coredump/27v66_i2c_intercept_promicro/electronics/ProMicro3.3V.step

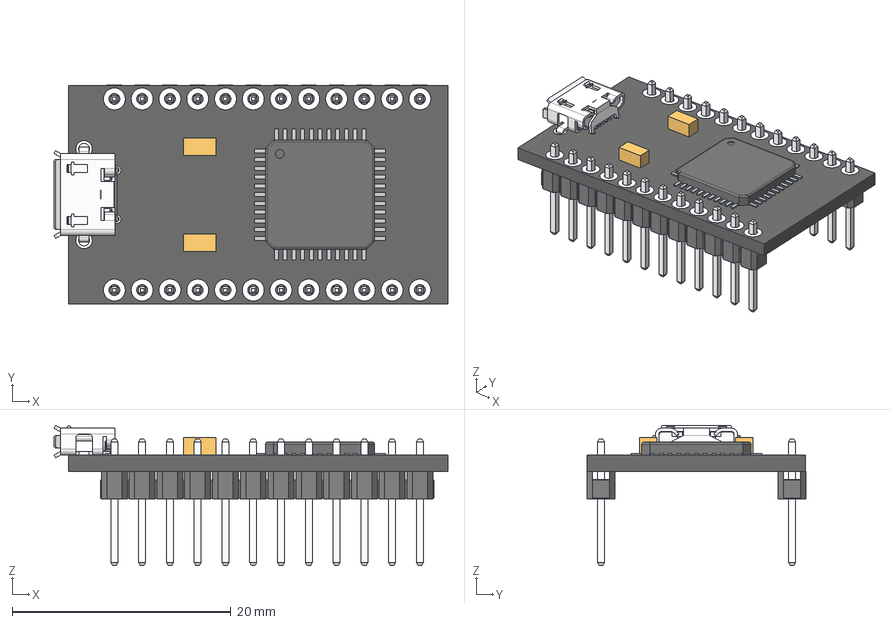
[picture p1: CAD file, 2021-08-10]
electronics/ProMicro3.3V.step
36.0 x 20.0 x 12.8 mm
Composants
pin x 24
PCB
USB
