coredump/27v66_i2c_intercept_promicro/electronics/electronics.pdf

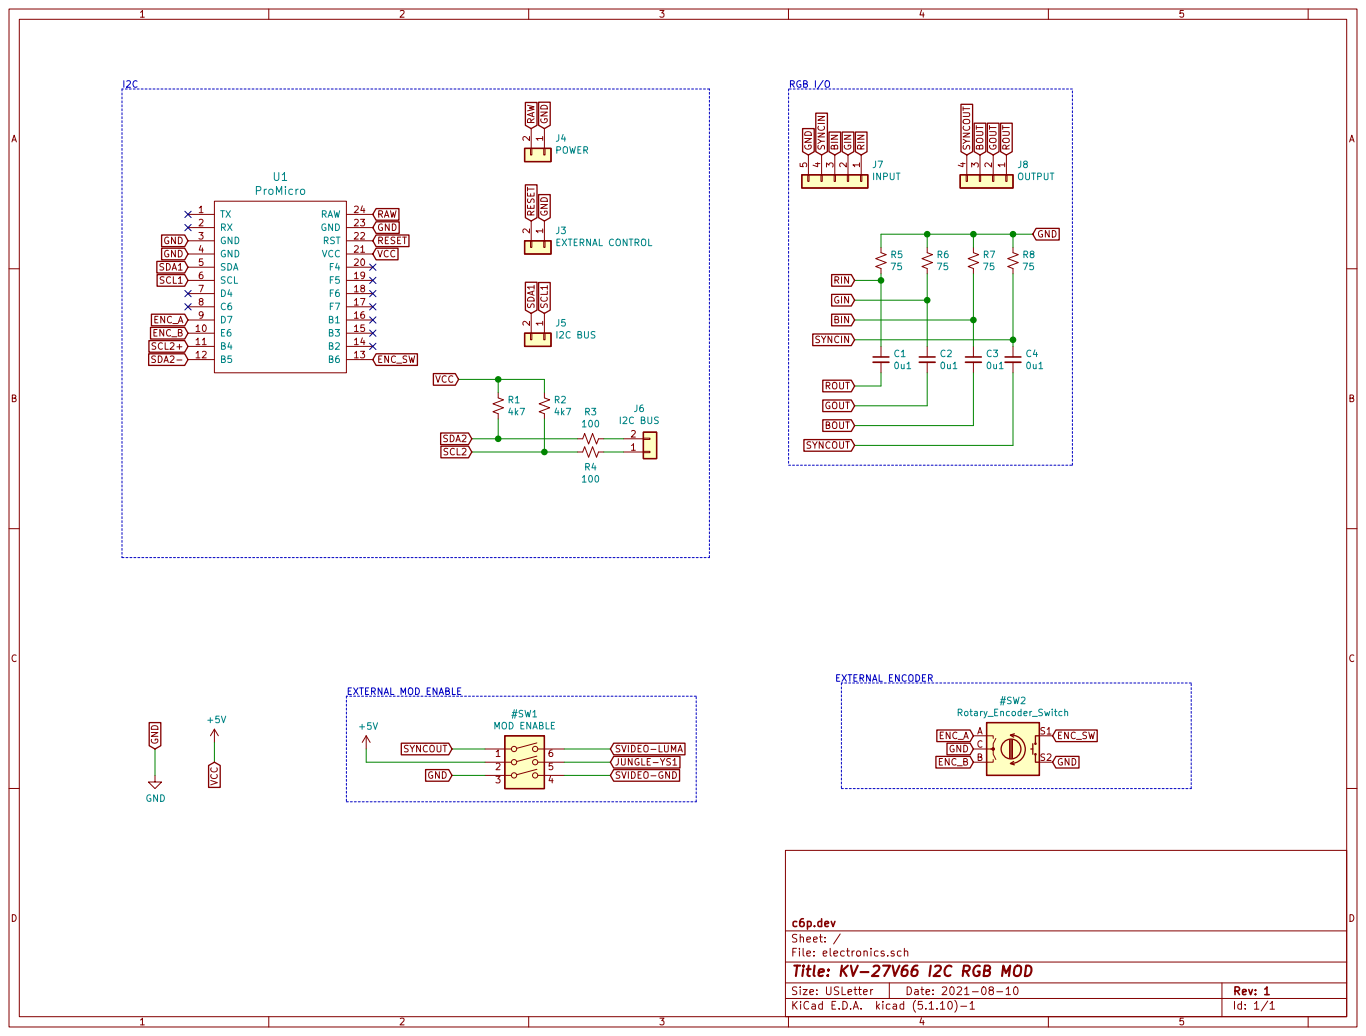
[picture p2: page 1]

BOUT BIN RAW GND

File: electronics.sch Sheet: / c6p.dev

Id: 1/1 Title: KV-27V66 I2C RGB MOD
