coredump/27v66_i2c_intercept_promicro/electronics/electronics.sch

## KiCad design electronics/electronics.sch (2021-09-01)

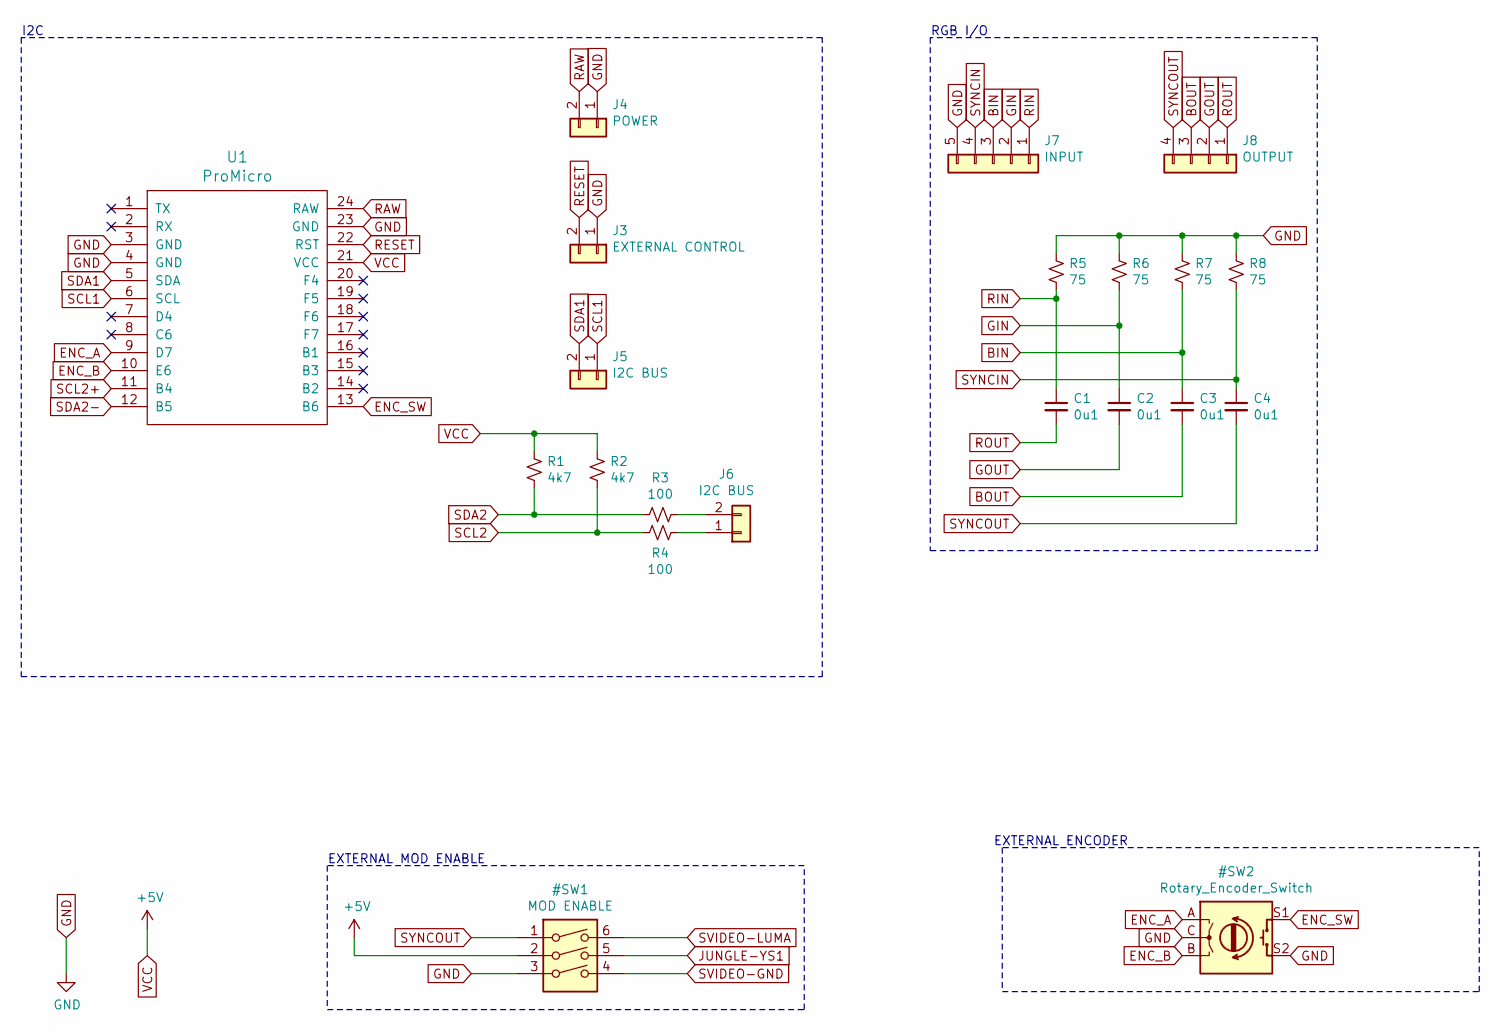
[picture p3: schematic electronics.sch]

Parts:
C1, C2, C3, C4: 0u1; C_0805_2012Metric_Pad1.18x1.45mm_HandSolder; Digikey PN 478-10836-1-ND
J3: EXTERNAL CONTROL; JST_XH_B2B-XH-AM_1x02_P2.50mm_Vertical
J4: POWER; JST_XH_B2B-XH-AM_1x02_P2.50mm_Vertical
J5, J6: I2C BUS; JST_XH_B2B-XH-AM_1x02_P2.50mm_Vertical
J7: INPUT; JST_XH_B5B-XH-AM_1x05_P2.50mm_Vertical
J8: OUTPUT; JST_XH_B4B-XH-AM_1x04_P2.50mm_Vertical
R1, R2: 4k7; R_0805_2012Metric_Pad1.20x1.40mm_HandSolder; Digikey PN RMCF0805FT4K70CT-ND
R3, R4: 100; R_0805_2012Metric_Pad1.20x1.40mm_HandSolder; Digikey PN RMCF0805FT100RCT-ND
R5, R6, R7, R8: 75; R_0805_2012Metric_Pad1.20x1.40mm_HandSolder; Digikey PN RMCF0805FT75R0CT-ND
U1: ProMicro

Connections:
+5V: C4.2, J3.1, J4.1, J7.5, J8.4, R1.1, R2.1, R5.1, R6.1, R7.1, R8.1, U1.3 (GND), U1.4 (GND), U1.9 (D7), U1.10 (E6), U1.13 (B6), U1.21 (VCC), U1.23 (GND)
BIN: C3.1, J7.3, R7.2
BOUT: C3.2, J8.3
GIN: C2.1, J7.2, R6.2
GOUT: C2.2, J8.2
unnamed: J6.1, R4.1
unnamed: J6.2, R3.1
RAW: J4.2, U1.24 (RAW)
RESET: J3.2, U1.22 (RST)
RIN: C1.1, J7.1, R5.2
ROUT: C1.2, J8.1
SCL1: J5.1, U1.6 (SCL)
SCL2: R2.2, R4.2
SCL2+: U1.11 (B4)
SDA1: J5.2, U1.5 (SDA)
SDA2: R1.2, R3.2
SDA2-: U1.12 (B5)
SYNCIN: C4.1, J7.4, R8.2

Notes on the sheet:
RGB I/O
I2C
EXTERNAL MOD ENABLE
EXTERNAL ENCODER
