coredump/27v66_i2c_intercept_promicro/(commit log)

2021-08-10 Adds kicad project
    [ProMicro3.3V.step, electronics.kicad_pcb, electronics.sch]
2021-08-10 Adding PDF schematics
    [electronics.sch]
2021-08-10 Changed some art
    [electronics.kicad_pcb]
2021-08-26 Last through hole
    [electronics.kicad_pcb, electronics.sch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]
2021-09-01 Encoder support
    [electronics.kicad_pcb, electronics.sch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]
2021-09-01 Remove failed pcb attempts
    [electronics.kicad_pcb]
2021-09-01 Updated schematics/pdf
2021-09-01 Fix encoder name on the schematic
    [electronics.sch]
